Jiexin-Zheng/NXP2020/摄像头上位机/摄像头上位机/esmartcar/ReadMe.txt

该软件需要 Microsoft .Framework 2.0支持，注意是2.0版本的。
如果您的电脑还没有安装2.0版本的，请从以下这些地方下载并安装。

http://www.crsky.com/soft/4818.html
http://www.xiazaiba.com/html/517.html
http://www.duote.com/soft/36225.html
http://www.onlinedown.net/soft/38669.htm
