Jiexin-Zheng/NXP2020/第一次买！必看此说明！否则一切白忙！.txt

1、本资料中电机驱动需要用四路PWM进行控制，但是在主板上只留了两路PWM，因为只需要两路就够了，电机驱动中对角的两个mos管是同时导通的，如果可以，请自己将电机驱动中对角的两个mos控制端短接，实在不会的就自己换个电机驱动吧。
2、摄像头安装时一定要安装正了，摄像头安装角度很有讲究，当液晶屏幕中的图像看到很清楚时候，直接将车放到直道正中间，调节摄像头左右偏向角度，式图像完全摆正。再调节摄像头俯仰角，使摄像头视野最下方距离车头最前端，中间有10厘米距离就可以了，也就是说摄像头是看不到车头前方10厘米以内的区域的。只要做到这点，我保证程序里所有的图像处理算法就会显现出效果，你的程序质量才能发挥出真正的力量。否则一切都是白忙！
3、焦距的调节：焦距就是转动摄像头镜头，在车前方60cm处贴横着贴一到黑胶带，当摄像头完全看起这道胶带就可以了。

以上必须做到！！！！否则一切白忙！
