Jiexin-Zheng/NXP2020/主板器件清单.xls

器件名称 | 描述 | 在原理图中的标号 | 封装 | LibRef | Quantity
电源端子（5mm间距的） |  | *H1 | 端子 | 端子5MM | 1
电机端子 |  | *H2 | 端子 | 端子5MM | 1
1.44LCD（山外小液晶） |  | 1.44LCD | 1.44LCD | 1.44LCD | 1
47uF钽电容 |  | C1, C5, C8 | 3216 | CAP-TAN-47uF | 3
0.1uF |  | C2, C3, C6, C7, C9, C10 | 0805 | CAP-0805_1 | 6
Cap Pol1电解电容 | Polarized Capacitor (Radial) | C4 | 470UF | Cap Pol1 | 1
10uF钽电容 |  | C11 | 3216封装 | CAP-TAN-10uF | 1
FFC_0.5_24 | FFC | FFC1 | 摄像头软排接口（和鹰眼对接） | FFC_0.5_24 | 1
钮子开关 | 钮子开关102 | K1, K2 | 钮子开关 | 钮子开关 | 2
LQ_KXXP144-SYSVG |  | LQ_KXXP144-SYSVG | LQ_KXXP144-SYSVG | LQ_KXXP144-SYSVG | 1
0905小型蜂鸣器 | 0905小蜂鸣器 | LS1 | 0905小型蜂鸣器 | 0905小型蜂鸣器 | 1
Header 4 | Header, 4-Pin | P1 | HDR1X4 | Header 4 | 1
Header 3 | Header, 3-Pin | P2 | HDR1X3 | Header 3 | 1
MOTO | Header, 3-Pin | P3 | HDR1X3 | Header 3 | 1
编码器 | Header, 4-Pin | P4 | HDR1X4 | Header 4 | 1
npn（三极管） |  | Q1 | npn（sot23封装） | npn | 1
R-0603 |  | R1 | R-0603 - duplicate1 | R-0603 | 1
3.3k |  | R2 | 0805 | RES-0805 | 1
1k |  | R3, R4 | 0805 | RES-0805 | 2
10k |  | R5, R6 | 0805 | RES-0805 | 2
LM2940S-3.3V(IMP2940) |  | U1, U2 | LM2940S-5.0（IMP2940） | LM2940S-5.0 | 2
LM2940S-5.0V(IMP2940) |  | U3 | LM2940S-5.0 | LM2940S-5.0 | 1
TL1963() |  | U4 | SOT223-5 | TL1963 | 1
摄像头采用的是山外鹰眼
单片机是龙邱K60
