Jiexin-Zheng/NXP2020/电机驱动器件清单.xls

器件名称 | 描述 | 原理图中的标号 | 封装 | LibRef | Quantity
MC33883(栅压驱动芯片) |  |  | 20-TERMINAL SOICW（sop封装） | MC33883 | 1
Cap Semi | Capacitor (Semiconductor SIM Model) | C1, C2, C3, C4, C5 | C1206 | Cap Semi | 5
LED3 | Typical BLUE SiC LED | D4 | 3.5X2.8X1.9 | LED3 | 1
MOTOR |  | M1 | 两口插座（绿5,mm） | MOTOR | 1
74ls244 |  | N1 | DIP20 | 74ls244 | 1
Header 8 | Header, 8-Pin | P1 | HDR1X8 | Header 8 | 1
IRF3205（mos管） | N-Channel MOSFET | Q1, Q2, Q3, Q4 | IRF3205(TO252封装) | MOSFET-N | 4
50 |  | R1, R2, R5, R6 | 0805 | RES | 4
10 |  | R3, R4 | 0805 | RES | 2
RES |  | R8 | 0805 | RES | 1
单刀开关 |  | S1 | DG1282-5.0 | 单刀开关 | 1
LM2940 | 3-Terminal Positive Voltage Regulator | U1 | 78XX（直插封装） | 78L05 | 1
