Jiexin-Zheng/NXP2020/(list of files, drawings)

Other design files:
B车模摄像头组主板/1.44LCD.PcbLib
B车模摄像头组主板/1.44LCD.SchLib
B车模摄像头组主板/B车模摄像头.PcbDoc
B车模摄像头组主板/B车模摄像头.PrjPcb
B车模摄像头组主板/B车模摄像头.SchDoc
B车模摄像头组主板/LQ_KXXP144-SYSVGPCB.PCBLIB
B车模摄像头组主板/LQ_KXXP144-SYSVGSCH.SCHLIB
电机驱动/飞思卡尔MOS管驱动电路/电机驱动电路.PrjPcb
电机驱动/飞思卡尔MOS管驱动电路/电机驱动电路.SchDoc
