Jiexin-Zheng/NXP2020/B车摄像头程序/program of  C_CAR/App/OLED.c

#include "common.h"
#include "include.h"



#define XLevelL		0x00
#define XLevelH		0x10
#define XLevel		((XLevelH&0x0F)*16+XLevelL)
#define Max_Column	128
#define Max_Row		  64
#define	Brightness	0xCF

/*
4线SPI使用说明：
VBT 供内部DC-DC电压，3.3~4.3V，如果使用5V电压，为保险起见串一个100~500欧的电阻
VCC 供内部逻辑电压 1.8~6V
GND 地

BS0 低电平
BS1 低电平
BS2 低电平

CS  片选管脚
DC  命令数据选择管脚
RES 模块复位管脚
D0（SCLK） ，时钟脚，由MCU控制
D1（MOSI） ，主输出从输入数据脚，由MCU控制

D2 悬空
D3-D7 ， 低电平 ， 也可悬空，但最好设为低电平
RD  低电平 ，也可悬空，但最好设为低电平
RW  低电平 ，也可悬空，但最好设为低电平
RD  低电平 ，也可悬空，但最好设为低电平
C7---D0（SCLK）时钟脚，由MCU控制
C6---D1（MOSI）主输出从输入数据脚，由MCU控制
C0---RST 模块复位管脚
C4---DC  命令数据选择管脚*/

/**************************** 引脚定义 ***********************************
														PE2    RST
														PE2    DC
														PE3    D1
														PE4    D0
*************************************************************************/
#define X_WIDTH 128
#define Y_WIDTH 64
//unsigned char OLED_buffer[1024];





//======================================
const byte F6x8[][6] =
{
    { 0x00, 0x00, 0x00, 0x00, 0x00, 0x00 },   // sp
    { 0x00, 0x00, 0x00, 0x2f, 0x00, 0x00 },   // !
    { 0x00, 0x00, 0x07, 0x00, 0x07, 0x00 },   // "
    { 0x00, 0x14, 0x7f, 0x14, 0x7f, 0x14 },   // #
    { 0x00, 0x24, 0x2a, 0x7f, 0x2a, 0x12 },   // $
    { 0x00, 0x62, 0x64, 0x08, 0x13, 0x23 },   // %
    { 0x00, 0x36, 0x49, 0x55, 0x22, 0x50 },   // &
    { 0x00, 0x00, 0x05, 0x03, 0x00, 0x00 },   // '
    { 0x00, 0x00, 0x1c, 0x22, 0x41, 0x00 },   // (
    { 0x00, 0x00, 0x41, 0x22, 0x1c, 0x00 },   // )
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
0x03,0x07,0x0F,0x1F,0x3F,0x7F,0xFF,0xFF,0xFE,0xFC,0xF1,0xE7,0x8F,0x3F,0x7F,0xFF,
0xFF,0xFF,0xFF,0xFF,0xFF,0xFF,0x7F,0x3F,0x8F,0xE7,0xF1,0xFC,0xFE,0xFF,0xFF,0x7F,
0x3F,0x1F,0x0F,0x07,0x03,0x00,0x00,0x00,0x00,0x00,0x00,0x00,0x00,0x00,0x00,0x00,
0x00,0x00,0x00,0x00,0x00,0x00,0x00,0x00,0x00,0x00,0x00,0x00,0x00,0x00,0x00,0x00,
0x00,0x01,0x01,0x03,0x07,0x07,0x0F,0x1C,0x39,0x07,0x0F,0x3F,0x0F,0x07,0x39,0x1C,
0x0F,0x07,0x07,0x03,0x01,0x01,0x00,0x00,0x00,0x00,0x00,0x00,0x00,0x00,0x00,0x00,
0x00,0x00,0x00,0x00,0x00,0x00,0x00,0x00,
};
*/

/*显示电量数组*/
/*byte dianchi[64] = {
0x00,0x00,0x00,0xF0,0xF0,0x00,0xFC,0x04,0x04,0x04,0x04,0x04,0x04,0x04,0x04,0x04,
0x04,0x04,0x04,0x04,0x04,0x04,0x04,0x04,0x04,0x04,0x04,0x04,0x04,0x04,0xFC,0x00,
0x00,0x00,0x00,0x0F,0x0F,0x00,0x3F,0x20,0x20,0x20,0x20,0x20,0x20,0x20,0x20,0x20,
0x20,0x20,0x20,0x20,0x20,0x20,0x20,0x20,0x20,0x20,0x20,0x20,0x20,0x20,0x3F,0x00
};*/

/*显示蓝牙信号数组*/
/*byte xinghao[64] = {
0x08,0x10,0x20,0x40,0xFF,0x82,0x44,0x28,0x10,0x00,0x00,0x00,0x00,0x00,0x00,0x00,
0x00,0x00,0x00,0x00,0x00,0x00,0x00,0x80,0x00,0xC0,0x00,0xE0,0x00,0xF0,0x00,0x00,
0x08,0x04,0x02,0x01,0x7F,0x20,0x11,0x0A,0x04,0x00,0x00,0x20,0x00,0x30,0x00,0x38,
0x00,0x3C,0x00,0x3E,0x00,0x3F,0x00,0x3F,0x00,0x3F,0x00,0x3F,0x00,0x3F,0x00,0x00
};*/

/*void LCD_WrDat(byte data)
{
	byte i=8;
	//LCD_CS=0;;
	DCHIGH();;;;//DC=1
   //NOP();
	asm("nop");
     CLKLOW();;;;//D0=0
   //NOP();
	 asm("nop");
  while(i--)
  {
    if(data&0x80)
		{MISOHIGH();;;;}//D1=1
    else
		{MISOLOW();;;;}//D1==0
   CLKHIGH();//D0=1
     //NOP();;;;;
		asm("nop");
   CLKLOW();;;;;//D0==0
    data<<=1;
  }
	//LCD_CS=1;
}*/

void LCD_WrDat(byte dat) 
{
byte  i;
DCHIGH(); 
for(i=0;i<8;i++) //发送一个八位数据 
{
if((dat << i) & 0x80)
{MISOHIGH();}
else  MISOLOW();
CLKLOW();
CLKHIGH();
}
}



void LCD_WrCmd(byte cmd)
{
	byte i=8;

	//LCD_CS=0;;
DCLOW();;;;;
 CLKLOW();;;;;
  //asm("nop");

  while(i--)
  {
    if(cmd&0x80)
		{MISOHIGH();;;;;}
    else
		{MISOLOW();;;;;;}
    CLKHIGH();;;;;
     //NOP();;;;;
	asm("nop");
   CLKLOW();;;;;
    cmd<<=1;;;;;
  }
	//LCD_CS=1;
}

void LCD_Set_Pos(byte x, byte y)
{
  LCD_WrCmd(0xb0+y);
  LCD_WrCmd(((x&0xf0)>>4)|0x10);
  LCD_WrCmd(x&0x0f);//|0x01);原来的版本图像整体右移一列，导致低128列移到第一列显示，不知道这么做是为什么，暂时先改回来
}

/*
A13---D0（SCLK）时钟脚，由MCU控制    13
A12---D1（MOSI）主输出从输入数据脚，由MCU控制   12
A15---RST 模块复位管脚  15
A14---DC  命令数据选择管脚     14*/
void OLED_Init(void)
{
//GPIO_Init(OLED_GPIO_DC, DC, GPIO_MODE_OUT_PP_HIGH_FAST);
//GPIO_Init(OLED_GPIO_D1, D1, GPIO_MODE_OUT_PP_HIGH_FAST);
//GPIO_Init(OLED_GPIO_D0, D0, GPIO_MODE_OUT_PP_HIGH_FAST);
//GPIO_Init(OLED_GPIO_RST, RSET, GPIO_MODE_OUT_PP_HIGH_FAST);
  
  
gpio_init(PTA5,GPO,1u);
gpio_init(PTA6,GPO,1u);  
gpio_init(PTA7,GPO,1u);
gpio_init(PTA12,GPO,1u);

	DCHIGH();
	CLKHIGH();

	RESLOW();
  	//LCD_DLY_ms(50);
        systick_delay_ms(100);
        RESHIGH();
/*
  LCD_WrCmd(0xae);//--turn off oled panel
  LCD_WrCmd(0x00);//---set low column address
  LCD_WrCmd(0x10);//---set high column address
  LCD_WrCmd(0x40);//--set start line address  Set Mapping RAM Display Start Line (0x00~0x3F)
  LCD_WrCmd(0x81);//--set contrast control register
  LCD_WrCmd(0xcf); // Set SEG Output Current Brightness   //亮度?
  LCD_WrCmd(0xa1);//--Set SEG/Column Mapping     0xa0左右反置 0xa1正常
   LCD_WrCmd(0xc8);//Set COM/Row Scan Direction   0xc0上下反置 0xc8正常
  //  LCD_WrCmd(0xa0);//--Set SEG/Column Mapping     0xa0左右反置 0xa1正常
 //  LCD_WrCmd(0xc0);//Set COM/Row Scan Direction   0xc0上下反置 0xc8正常
  LCD_WrCmd(0xa6);//--set normal display
  LCD_WrCmd(0xa8);//--set multiplex ratio(1 to 64)
  LCD_WrCmd(0x3f);//--1/64 duty
  LCD_WrCmd(0xd3);//-set display offset	Shift Mapping RAM Counter (0x00~0x3F)
  LCD_WrCmd(0x00);//-not offset
  LCD_WrCmd(0xd5);//--set display clock divide ratio/oscillator frequency
  LCD_WrCmd(0x80);//--set divide ratio, Set Clock as 100 Frames/Sec
  LCD_WrCmd(0xd9);//--set pre-charge period
  LCD_WrCmd(0xf1);//Set Pre-Charge as 15 Clocks & Discharge as 1 Clock
  LCD_WrCmd(0xda);//--set com pins hardware configuration
  LCD_WrCmd(0x12);
  LCD_WrCmd(0xdb);//--set vcomh
  LCD_WrCmd(0x40);//Set VCOM Deselect Level
  LCD_WrCmd(0x20);//-Set Page Addressing Mode (0x00/0x01/0x02)
  LCD_WrCmd(0x02);//
  LCD_WrCmd(0x8d);//--set Charge Pump enable/disable
  LCD_WrCmd(0x14);//--set(0x10) disable
  LCD_WrCmd(0xa4);// Disable Entire Display On (0xa4/0xa5)
  LCD_WrCmd(0xa6);// Disable Inverse Display On (0xa6/a7)
  LCD_WrCmd(0xaf);//--turn on oled panel
  LCD_Fill(0);  //初始清屏
  LCD_Set_Pos(0,0);
*/

LCD_WrCmd(0xae);//--turn off oled panel
LCD_WrCmd(0x00);//---set low column address
LCD_WrCmd(0x10);//---set high column address
LCD_WrCmd(0x40);//--set start line address  Set Mapping RAM Display Start Line (0x00~0x3F)
LCD_WrCmd(0x81);//--set contrast control register//设置对比度控制寄存器
LCD_WrCmd(0x11); // Set SEG Output Current Brightness//输出电流设定亮度0xcf
LCD_WrCmd(0xa1);//--Set SEG/Column Mapping     0xa0左右反置 0xa1正常
LCD_WrCmd(0xc8);//Set COM/Row Scan Direction   0xc0上下反置 0xc8正常
LCD_WrCmd(0xa6);//--set normal display
LCD_WrCmd(0xa8);//--set multiplex ratio(1 to 64)
LCD_WrCmd(0x3f);//--1/64 duty
LCD_WrCmd(0xd3);//-set display offset	Shift Mapping RAM Counter (0x00~0x3F)
LCD_WrCmd(0x00);//-not offset
LCD_WrCmd(0xd5);//--set display clock divide ratio/oscillator frequency
LCD_WrCmd(0x80);//--set divide ratio, Set Clock as 100 Frames/Sec
LCD_WrCmd(0xd9);//--set pre-charge period
LCD_WrCmd(0xf1);//Set Pre-Charge as 15 Clocks & Discharge as 1 Clock
LCD_WrCmd(0xda);//--set com pins hardware configuration
LCD_WrCmd(0x12);
LCD_WrCmd(0xdb);//--set vcomh
LCD_WrCmd(0x40);//Set VCOM Deselect Level
LCD_WrCmd(0x20);//-Set Page Addressing Mode (0x00/0x01/0x02)
LCD_WrCmd(0x02);//
LCD_WrCmd(0x8d);//--set Charge Pump enable/disable
LCD_WrCmd(0x14);//--set(0x10) disable
LCD_WrCmd(0xa4);// Disable Entire Display On (0xa4/0xa5)
LCD_WrCmd(0xa6);// Disable Inverse Display On (0xa6/a7) 
LCD_WrCmd(0xaf);//--turn on oled panel        
LCD_Fill(0x00);  //初始清屏
LCD_Set_Pos(0,0);         
	//DZXH_LOGO();
}




/**************************实现函数********************************************
*函数原型:		void LCD_SetXY(unsigned char X,unsigned char Y)
*功　　能:		将OLED的光标设置到 X,Y 坐标。
*******************************************************************************/
void LCD_SetXY(unsigned char X,unsigned char Y)
{
	LCD_WrCmd(0x22);
	LCD_WrCmd(Y);
	LCD_WrCmd(7);
	LCD_WrCmd(0x21);
	LCD_WrCmd(X);
	LCD_WrCmd(127);
}

void LCD_Fill(byte bmp_data)
{
	byte y,x;

	for(y=0;y<8;y++)
	{
		LCD_WrCmd(0xb0+y);
		LCD_WrCmd(0x01);
		LCD_WrCmd(0x10);
		for(x=0;x<X_WIDTH;x++)
			LCD_WrDat(bmp_data);
	}
}

void LCD_CLS(void)
{
	byte y,x;
	for(y=0;y<8;y++)
	{
		LCD_WrCmd(0xb0+y);
		LCD_WrCmd(0x01);
		LCD_WrCmd(0x10);
		for(x=0;x<X_WIDTH;x++)
			LCD_WrDat(0);
	}
}
void LCD_DLY_ms(word ms)
{
  word a;
  while(ms)
  {
    a=2350;
    while(a--);
    ms--;
  }
  return;
}


//==============================================================
//函数名： void LCD_PutPixel(byte x,byte y)
//功能描述：绘制一个点（x,y）
//参数：真实坐标值(x,y),x的范围0～127，y的范围0～64
//返回：无
//==============================================================
void LCD_PutPixel(byte x,byte y)
{
	byte data1;  //data1当前点的数据

        LCD_Set_Pos(x,y);
	data1 = 0x01<<(y%8);
	LCD_WrCmd(0xb0+(y>>3));
	LCD_WrCmd(((x&0xf0)>>4)|0x10);
	LCD_WrCmd((x&0x0f)|0x00);
	LCD_WrDat(data1);
}



/***********功能描述：显示显示BMP图片128×64起始点坐标(x,y),x的范围0～127，y为页的范围0～7*****************/
void Draw_pot(unsigned char x,unsigned char y,unsigned char t)
{ 	
 
 unsigned char  bx, tmp_lcd=0;
if(x>127||y>63)return;

bx=y%8;
tmp_lcd=1<<(bx);
if(t)
 DRAWPOT[128*(y/8)+x]|=tmp_lcd;
else
 DRAWPOT[128*(y/8)+x]&=~tmp_lcd;
}


void LCD_PXXxYYCHtoBMP(unsigned char xx,unsigned char yy,unsigned char FXXxYY[],unsigned char x,unsigned char y,unsigned char N,unsigned char p)//字符大小XX*YY,对应大小的数组， x坐标，y坐标，第几个数或者字符，阴文/阳文
{
unsigned char t,d,wm=0;
unsigned int adder=(xx*yy)/8*N;
if(yy%8!=0)
d=1;
else
d=0;
for(t=0;t<(yy/8+d);t++){
  for(wm=0;wm<xx;wm++) 
{
if(p==0)
DRAWPOTtempm[128*((y/8)+t)+x+wm]=FXXxYY[adder];
else
DRAWPOTtempm[128*((y/8)+t)+x+wm]=~FXXxYY[adder];
adder += 1;
}
}
}


/***********功能描述：显示显示BMP图片128×64起始点坐标(x,y),x的范围0～127，y为页的范围0～7*****************/
void Draw_BMP(unsigned char x0,unsigned char y0,unsigned char x1,unsigned char y1,unsigned char BMP[])
{ 	
 unsigned int j=0;
 unsigned char x,y;
  
  if(y1%8==0) y=y1/8;      
  else y=y1/8+1;
	for(y=y0;y<y1;y++)
	{
		LCD_Set_Pos(x0,y);				
    for(x=x0;x<x1;x++)
	    {      
	    	LCD_WrDat(BMP[j++]);	    	
	    }
	}
}


//滚动效果调试
void gundong(void){
int d,s;
//if(flag) {
  
for(s=0;s<128;s++) 
   {
  for(d=0;d<128;d++) 
    {
DRAWPOTm[d]=DRAWPOTm[d+1];
DRAWPOTm[d+128*1]=DRAWPOTm[(d+1+128*1)];
DRAWPOTm[d+128*2]=DRAWPOTm[(d+1+128*2)];
DRAWPOTm[d+128*3]=DRAWPOTm[(d+1+128*3)];
DRAWPOTm[d+128*4]=DRAWPOTm[(d+1+128*4)];
DRAWPOTm[d+128*5]=DRAWPOTm[(d+1+128*5)];
DRAWPOTm[d+128*6]=DRAWPOTm[(d+1+128*6)];
DRAWPOTm[d+128*7]=DRAWPOTm[(d+1+128*7)];
   }
DRAWPOTm[127]=DRAWPOTtempm[0+s]; 
DRAWPOTm[127+128*1]=DRAWPOTtempm[1*128+s];
DRAWPOTm[127+128*2]=DRAWPOTtempm[2*128+s];
DRAWPOTm[127+128*3]=DRAWPOTtempm[3*128+s];
DRAWPOTm[127+128*4]=DRAWPOTtempm[4*128+s];
DRAWPOTm[127+128*5]=DRAWPOTtempm[5*128+s];
DRAWPOTm[127+128*6]=DRAWPOTtempm[6*128+s];
DRAWPOTm[127+128*7]=DRAWPOTtempm[7*128+s];
 

Draw_BMP(0,0,128,8,DRAWPOTm);
    }
   // flag=0;
}

//    else
//Draw_BMP(0,0,128,8,DRAWPOTm);
    
   // return flag;

uint gundong_128(uint flag){
//int d,s;
#if 0
if(flag) {
  
for(s=0;s<128;s++) 
   {
  for(d=0;d<128;d++) 
    {
DRAWPOTm[d]=DRAWPOTm[d+1];
DRAWPOTm[d+128*1]=DRAWPOTm[(d+1+128*1)];
DRAWPOTm[d+128*2]=DRAWPOTm[(d+1+128*2)];
DRAWPOTm[d+128*3]=DRAWPOTm[(d+1+128*3)];
DRAWPOTm[d+128*4]=DRAWPOTm[(d+1+128*4)];
DRAWPOTm[d+128*5]=DRAWPOTm[(d+1+128*5)];
DRAWPOTm[d+128*6]=DRAWPOTm[(d+1+128*6)];
DRAWPOTm[d+128*7]=DRAWPOTm[(d+1+128*7)];
   }
DRAWPOTm[127]=DRAWPOTtempm[0+s]; 
DRAWPOTm[127+128*1]=DRAWPOTtempm[1*128+s];
DRAWPOTm[127+128*2]=DRAWPOTtempm[2*128+s];
DRAWPOTm[127+128*3]=DRAWPOTtempm[3*128+s];
DRAWPOTm[127+128*4]=DRAWPOTtempm[4*128+s];
DRAWPOTm[127+128*5]=DRAWPOTtempm[5*128+s];
DRAWPOTm[127+128*6]=DRAWPOTtempm[6*128+s];
DRAWPOTm[127+128*7]=DRAWPOTtempm[7*128+s];
 

Draw_BMP(0,0,128,8,DRAWPOTm);
    }
    flag=0;
}
    else
#endif
//Draw_BMP(0,0,128,8,DRAWPOTm);
Draw_BMP(0,0,128,8,DRAWPOTtempm);
//Draw_BMP(0,0,128,8,BMP3);
//LCD_PXXxYYCHtoBMPL(128,64,DRAWPOTm,0,0,0,0,1);//clear

    
    return flag;
}





void clear_drawpottempm(void) 
{int k;
for(k=0;k<128*8;k++)
 DRAWPOTtempm[k]=0x00;
}


void LCD_P8x16StrtoBMPL(unsigned char x,unsigned char y,signed char ch[],unsigned char z)
{
unsigned char c=0,i=0,j=0;
while (ch[j]!='\0')
{    
c =ch[j]-32;
if(x>120){x=0;y++;}
//LCD_Set_Pos(x,y);    
for(i=0;i<8;i++) {
if(z)
DRAWPOTtempm[128*(y/8)+x+i]=F8X16[c*16+i]; 
else  
DRAWPOTm[128*(y/8)+x+i]=F8X16[c*16+i]; 
}
//LCD_Set_Pos(x,y+8);    
for(i=0;i<8;i++) {
if(z)
DRAWPOTtempm[128*((y/8)+1)+x+i]=F8X16[c*16+i+8];
else  
DRAWPOTm[128*((y/8)+1)+x+i]=F8X16[c*16+i+8];
}
x+=8;
j++;
}
}


void LCD_PXXxYYCHtoBMPL(unsigned char xx,unsigned char yy,unsigned char FXXxYY[],unsigned char x,unsigned char y,unsigned char N,unsigned char p,unsigned char c)//字符大小XX*YY,对应大小的数组， x坐标，y坐标，第几个数或者字符，阴文/阳文,写入哪个GRAM
{
unsigned char t,d,wm=0;
unsigned int adder=(xx*yy)/8*N;
if(yy%8!=0)
d=1;
else
d=0;
for(t=0;t<(yy/8+d);t++){
  for(wm=0;wm<xx;wm++) 
{
if(p==0)
 { if(c)
   DRAWPOTtempm[128*((y/8)+t)+x+wm]=FXXxYY[adder];
 else
  DRAWPOTm[128*((y/8)+t)+x+wm]=FXXxYY[adder];
}
else 
{
if(c)
  DRAWPOTtempm[128*((y/8)+t)+x+wm]=~FXXxYY[adder];
 else
  DRAWPOTm[128*((y/8)+t)+x+wm]=~FXXxYY[adder];
}
adder+= 1;
}
}
}



void ceshi_lock(void) 
{

 clear_drawpottempm();
 //LCD_PXXxYYCHtoBMPL(128,64,cs,0,0,0,0,1);
 
 LCD_P8x16StrtoBMPL(1*16,2*8,"Screen lock!",1);     //字符大小XX*YY,对应大小的数组， x坐标，y坐标，第几个数或者字符，阴文/阳文,写入哪个GRAM
 LCD_P8x16StrtoBMPL(1*16,4*8,"The car run!",1);
}



/*void LCD_PXXxYYCHtoBMPL(unsigned char xx,unsigned char yy,unsigned char FXXxYY[],unsigned char x,unsigned char y,unsigned char N,unsigned char p,unsigned char c)//字符大小XX*YY,对应大小的数组， x坐标，y坐标，第几个数或者字符，阴文/阳文,写入哪个GRAM
{
unsigned char t,d,wm=0;
unsigned int adder=(xx*yy)/8*N;
if(yy%8!=0)
d=1;
else
d=0;
for(t=0;t<(yy/8+d);t++){
  for(wm=0;wm<xx;wm++) 
{
if(p==0)
 { if(c)
   DRAWPOTtempm[128*((y/8)+t)+x+wm]=FXXxYY[adder];
 else
  DRAWPOTm[128*((y/8)+t)+x+wm]=FXXxYY[adder];
}
else 
{
if(c)
  DRAWPOTtempm[128*((y/8)+t)+x+wm]=~FXXxYY[adder];
 else
  DRAWPOTm[128*((y/8)+t)+x+wm]=~FXXxYY[adder];
}
adder += 1;
}
}
}*/

void ceshi(void)
{
  
LCD_PXXxYYCHtoBMP(16,16,F16x16tbm,0,0,4,0);  
LCD_PXXxYYCHtoBMP(16,16,F16x16tbm,16*7,0,7,0);

LCD_PXXxYYCHtoBMP(16,16,F16x16tbm,16*2,0,8,0);
LCD_PXXxYYCHtoBMP(16,16,F16x16tbm,16*3,0,9,0);
LCD_PXXxYYCHtoBMP(16,16,F16x16tbm,16*4,0,10,0);
LCD_PXXxYYCHtoBMP(16,16,F16x16tbm,16*5,0,11,0);

LCD_PXXxYYCHtoBMP(16,16,F16x16tbm,16*1,0,12,0);
LCD_PXXxYYCHtoBMP(16,16,F16x16tbm,16*6,0,13,0);
  
LCD_PXXxYYCHtoBMP(24,24,F24x24,2,16,0,1);
LCD_PXXxYYCHtoBMP(24,24,F24x24,27,16,1,0);
LCD_PXXxYYCHtoBMP(24,24,F24x24,52,16,2,0);
LCD_PXXxYYCHtoBMP(24,24,F24x24,77,16,3,0);
LCD_PXXxYYCHtoBMP(24,24,F24x24,102,16,4,0);

LCD_PXXxYYCHtoBMP(24,24,F24x24,2,40,5,0);
LCD_PXXxYYCHtoBMP(24,24,F24x24,27,40,6,0);
LCD_PXXxYYCHtoBMP(24,24,F24x24,52,40,7,0);
LCD_PXXxYYCHtoBMP(24,24,F24x24,77,40,8,0);
LCD_PXXxYYCHtoBMP(24,24,F24x24,102,40,9,0);
     Draw_BMP(0,0,128,8,DRAWPOT);
}

void ceshi2(void)
{
  

     Draw_BMP(0,0,128,8,cs);
}
//==============================================================
//函数名： void LCD_Rectangle(byte x1,byte y1,
//                   byte x2,byte y2,byte color,byte gif)
//功能描述：绘制一个实心矩形
//参数：左上角坐标（x1,y1）,右下角坐标（x2，y2）
//      其中x1、x2的范围0～127，y1，y2的范围0～63，即真实坐标值
//返回：无
//==============================================================
/*void LCD_Rectangle(byte x1,byte y1,byte x2,byte y2,byte gif)
{
	byte n;

	LCD_Set_Pos(x1,y1>>3);
	for(n=x1;n<=x2;n++)
	{
		LCD_WrDat(0x01<<(y1%8));
		if(gif == 1) 	LCD_DLY_ms(50);
	}
	LCD_Set_Pos(x1,y2>>3);
    for(n=x1;n<=x2;n++)
	{
		LCD_WrDat(0x01<<(y2%8));
		if(gif == 1) 	LCD_DLY_ms(5);
	}

}*/
//==============================================================
//函数名：LCD_P6x8Str(byte x,byte y,byte *p)
//功能描述：写入一组标准ASCII字符串
//参数：显示的位置（x,y），y为页范围0～7，要显示的字符串
//返回：无
//==============================================================




void LCD_P6x8Str(byte x,byte y,byte ch[])
{
  byte c=0,i=0,j=0;
  while (ch[j]!='\0')
  {
    c =ch[j]-32;
    if(x>126){x=0;y++;}
    LCD_Set_Pos(x,y);
  	for(i=0;i<6;i++)
  	  LCD_WrDat(F6x8[c][i]);
  	x+=6;
  	j++;
  }
}


//==============================================================
//函数名：LCD_P8x16Str(byte x,byte y,byte *p)
//功能描述：写入一组标准ASCII字符串
//参数：显示的位置（x,y），y为页范围0～7，要显示的字符串
//返回：无
//==============================================================
/*void LCD_P8x16Str(byte x,byte y,byte ch[])
{
  byte c=0,i=0,j=0;

  while (ch[j]!='\0')
  {
    c =ch[j]-32;
    if(x>120){x=0;y++;}
    LCD_Set_Pos(x,y);
  	for(i=0;i<8;i++)
  	  LCD_WrDat(F8X16[c*16+i]);
  	LCD_Set_Pos(x,y+1);
  	for(i=0;i<8;i++)
  	  LCD_WrDat(F8X16[c*16+i+8]);
  	x+=8;
  	j++;
  }
}*/
//输出汉字字符串
/*
void LCD_P14x16Str(byte x,byte y,byte ch[])
{
	byte wm=0,ii = 0;
	word adder=1;

	while(ch[ii] != '\0')
	{
  	wm = 0;
  	adder = 1;
  	while(F14x16_Idx[wm] > 127)
  	{
  		if(F14x16_Idx[wm] == ch[ii])
  		{
  			if(F14x16_Idx[wm + 1] == ch[ii + 1])
  			{
  				adder = wm * 14;
  				break;
  			}
  		}
  		wm += 2;
  	}
  	if(x>118){x=0;y++;}
  	LCD_Set_Pos(x , y);
  	if(adder != 1)// 显示汉字
  	{
  		LCD_Set_Pos(x , y);
  		for(wm = 0;wm < 14;wm++)
  		{
  			LCD_WrDat(F14x16[adder]);
  			adder += 1;
  		}
  		LCD_Set_Pos(x,y + 1);
  		for(wm = 0;wm < 14;wm++)
  		{
  			LCD_WrDat(F14x16[adder]);
  			adder += 1;
  		}
  	}
  	else			  //显示空白字符
  	{
  		ii += 1;
      LCD_Set_Pos(x,y);
  		for(wm = 0;wm < 16;wm++)
  		{
  				LCD_WrDat(0);
  		}
  		LCD_Set_Pos(x,y + 1);
  		for(wm = 0;wm < 16;wm++)
  		{
  				LCD_WrDat(0);
  		}
  	}
  	x += 14;
  	ii += 2;
	}
}
//输出汉字和字符混合字符串
void LCD_Print(byte x, byte y, byte ch[])
{
	byte ch2[3];
	byte ii=0;
	while(ch[ii] != '\0')
	{
		if(ch[ii] > 127)
		{
			ch2[0] = ch[ii];
	 		ch2[1] = ch[ii + 1];
			ch2[2] = '\0';			//汉字为两个字节
			LCD_P14x16Str(x , y, ch2);	//显示汉字
			x += 14;
			ii += 2;
		}
		else
		{
			ch2[0] = ch[ii];
			ch2[1] = '\0';			//字母占一个字节
			LCD_P8x16Str(x , y , ch2);	//显示字母
			x += 8;
			ii+= 1;
		}
	}
}*/

//==============================================================
//函数名： void Draw_BMP(byte x,byte y)
//功能描述：显示BMP图片128×64
//参数：起始点坐标(x,y),x的范围0～127，y为页的范围0～7
//返回：无
//==============================================================
/*void Draw_BMP(byte x0,byte y0,byte x1,byte y1,byte *bmp)
{
//  word ii=0;
  byte x,y;

  if(y1%8==0)
    y=y1/8;
  else
    y=y1/8+1;
  for(y=y0;y<=y1;y++)
  {
    LCD_Set_Pos(x0,y);
    for(x=x0;x<=x1;x++)
    {
      LCD_WrDat(*bmp++);
    }
  }
}*/

void Dis_Num(byte y, byte x, unsigned int num,byte N)
{
//  byte line;
  byte j=0;
  byte n[6]={0};
  x=x*8;
  n[0]=(num/10000)%10;
  n[1]=(num/1000)%10;
  n[2]=(num/100)%10;
  n[3]=(num/10)%10;
  n[4]=num%10;
//  n[6]='\0';
  for(j=0;j<5;j++)
	n[j]=n[j]+16+32;
  LCD_P6x8Str(x,y,&n[5-N]);//从ACSII码表中读取字节，然后写入液晶
}

void Dis_Numbfb(byte y, byte x, u8 num)
{
  byte n[5]={0};
  x=x*8;
  n[0]=((num/100)%10)+16+32;
   if(n[0]==48)
	 n[0]=32;
  n[1]=((num/10)%10)+16+32;
   //if(n[1]==48)
	// n[1]=32;
  n[2]=(num%10)+16+32;
  n[3]=37;
  LCD_P8x16Str(x,y,&n[0]);//从ACSII码表中读取字节，然后写入液晶
}

/*void Dis_LOGO()
{
	Draw_BMP(36,0,92,7,(u8*)logo);
	LCD_DLY_ms(400);            //显示LOGO延时
	LCD_DLY_ms(400);            //显示LOGO延时
	LCD_DLY_ms(400);            //显示LOGO延时
	LCD_Fill(0x00);  //初始清屏
}*/

void Dis_err(byte y, byte x, s16 num)
{
  byte n[6]={0};
  x=x*8;
  if(num<0)
  {
  	n[0]=45;
	num=-num;
  }
  else if(num>=0)
  {
  	n[0]=43;
  }
  n[1]=(num/1000)%10+16+32;
  n[2]=(num/100)%10+16+32;
  n[3]=46;
  n[4]=(num/10)%10+16+32;
  n[5]=num%10+16+32;
  LCD_P6x8Str(x,y,&n[0]);//从ACSII码表中读取字节，然后写入液晶
}
/*
void Draw_Power(u16 TSC,u8 qie)
{
  byte is;
  byte n[5]={0};
  if(qie==0)
  {
	if(TSC<=630)
	  TSC=630;
	TSC=TSC-630;
	TSC=TSC/10;
	if(TSC>21)
	   TSC=21;
    for(is=0;is<21;is++)
	{
		dianchi[8+is]=0x04;
		dianchi[40+is]=0x20;
	}
    for(is=0;is<TSC;is++)
	{
		dianchi[28-is]=0xF4;
		dianchi[60-is]=0x2F;
	}
	Draw_BMP(96,0,127,1,dianchi);
  }
  if(qie==1)
  {
	TSC=TSC;
	n[0]=(TSC/100)%10+16+32;
    n[1]=46;
    n[2]=(TSC/10)%10+16+32;
    n[3]=TSC%10+16+32;
//    n[4]='\n';
    LCD_P8x16Str(96,0,&n[0]);//从ACSII码表中读取字节，然后写入液晶
  	//Dis_Num(0,11,TSC,4) ;//3
  }

}*/
/*
void Draw_XH()
{
	Draw_BMP(0,0,31,1,xinghao);
}
*/

/*
void LCD_Write_Char(unsigned char ASCII)
{
    unsigned char n;

    ASCII -= 32; //ASCII码-32 得到ASCII字符在点阵中的位置

    for (n=0; n<6; n++)
		LCD_WrDat((F6x8[ASCII][n]));
}*/
/*
void Display_Bar(unsigned char x,unsigned char y,unsigned char num)
{
unsigned char i,j;

	if(num>249)num=249;//限制最大输入为250
i=num/10;  //0-25
LCD_SetXY(x,y);
LCD_WrDat(0x7e);
LCD_WrDat(0x81);
for(j=0;j<i;j++) //开始填充有效的条
{
LCD_WrDat(0xbd);
LCD_WrDat(0xbd);
LCD_WrDat(0xbd);
LCD_WrDat(0x81);
}
if(((num%10)==0)||((num%10)<3))
	{
	LCD_WrDat(0x81);
	LCD_WrDat(0x81);
	LCD_WrDat(0x81);
	LCD_WrDat(0x81);
	}
	else if(((num%10)>=3)&&((num%10)<6))
	{
	LCD_WrDat(0xbd);
	LCD_WrDat(0x81);
	LCD_WrDat(0x81);
	LCD_WrDat(0x81);
	}else if(((num%10)>=6)&&((num%10)<9))
	{
	LCD_WrDat(0xbd);
	LCD_WrDat(0xbd);
	LCD_WrDat(0x81);
	LCD_WrDat(0x81);
	}
	else{
	LCD_WrDat(0xbd);
	LCD_WrDat(0xbd);
	LCD_WrDat(0xbd);
	LCD_WrDat(0x81);
	}

for(j=0;j<24-i;j++) //填充空白条
{
LCD_WrDat(0x81);
LCD_WrDat(0x81);
LCD_WrDat(0x81);
LCD_WrDat(0x81);
}
LCD_WrDat(0x7e);
//显示输入的数据十进制值
//LCD_P6x8Str(110,y,100);
//LCD_Write_Char(num/100+0x30);
//LCD_Write_Char(num%100/10+0x30);
//LCD_Write_Char(num%10+0x30);

}*/
/*
void LED_PrintImage(byte *pucTable, word usRowNum, word usColumnNum)
{
    byte ucData;
    word i,j,k,m,n;
    word usRowTmp;

    m = usRowNum >> 3;   //计算图片行数以8位为一组完整的组数
    n = usRowNum % 8;    //计算分完组后剩下的行数

    for(i = 0; i < m; i++) //完整组行扫描
    {
        LCD_Set_Pos(0,i);
        usRowTmp = i << 3;    //计算当前所在行的下标
        for(j = 0; j < usColumnNum; j++) //列扫描
        {
            ucData = 0;
            for(k = 0; k < 8; k++) //在i组中对这8行扫描
            {
                ucData = ucData >> 1;
                if((pucTable + (usRowTmp + k) * usColumnNum)[j] == 0)
                {
                    ucData = ucData | 0x80;
                }

            }
            LCD_WrDat(ucData);
        }
    }

    LCD_Set_Pos(0,(u8)i); //设置剩下的行显示的起始坐标
    usRowTmp = i << 3;       //计算当前所在行的下标
    for(j = 0; j < usColumnNum; j++) //列扫描
    {
        ucData = 0;
        for(k = 0; k < n; k++) //对剩下的行扫描
        {
            ucData = ucData >> 1;
            if((pucTable + (usRowTmp + k) * usColumnNum)[j] == 0)
            {
                ucData = ucData | 0x80;
            }

        }
        ucData = ucData >> (8 - n);
        LCD_WrDat(ucData);
    }

    return;
}*/



//void OLED_clearbuffer(void)
//{
//	unsigned int j;
//	for(j=0;j<1024;j++)
//	  OLED_buffer[j]=0;
//}

/*void OLED_upbuffer(void)
{
    unsigned int j;
	LCD_SetXY(0,0);
	for(j=0;j<1024;j++)
	  LCD_WrDat(OLED_buffer[j]);
}*/

/*
void LCD_Fill2(byte *bmp_data)
{
	byte y,x;

	for(y=0;y<8;y++)
	{
		LCD_WrCmd(0xb0+y);
		LCD_WrCmd(0x01);
		LCD_WrCmd(0x10);
		for(x=0;x<X_WIDTH;x++)
			LCD_WrDat(*bmp_data++);
	}
}*/

//void OLED_upbuffer(void)
//{
//  LCD_Fill2(OLED_buffer);

//}

/*
void SetPixelbuffer(unsigned char x, unsigned char y, unsigned char color)
{
	if ((x >= COLSIZE-1) || (y >= ROWSIZE*8-1))
		return;
		unsigned char temp;
		temp=OLED_buffer[(y/8)*128+x];
		if (color)temp|=(1<<(y%8));
		else temp&=~(1<<(y%8));
		OLED_buffer[(y/8)*128+x]=temp;
}*/

/*
void DrawLine(unsigned char x0, unsigned char y0, unsigned char x1, unsigned char y1, unsigned char color)
{
	int t;
	char steep = DIF(y1 , y0) > DIF(x1 , x0);
	if (steep)
	{
		t = x0;
		x0 = y0;
		y0 = t;
		t = x1;
		x1 = y1;
		y1 = t;
	}

	if (x0 > x1)
	{
		t = x0;
		x0 = x1;
		x1 = t;

		t = y0;
		y0 = y1;
		y1 = t;
	}

	int dx, dy;
	dx = x1 - x0;
	dy = DIF(y1 , y0);

	int err = (dx / 2);
	int ystep;

	if (y0 < y1)
	{
		ystep = 1;
	}
	else
	{
		ystep = -1;
	}

	for (; x0 < x1; x0++)
	{
		if (steep)
		{
			SetPixelbuffer(y0, x0, color);
		}
		else
		{
			SetPixelbuffer(x0, y0, color);
		}
		err -= dy;
		if (err < 0)
		{
			y0 += (unsigned char)ystep;
			err += dx;
		}
	}
}*/


/**************************************************************************************
                                 *
                                * *
                               *   *
                              *     *
                   * * * * * *       * * * * * *
                    *     * *         * *     *
                     *   * *           * *   *
                      * * *             * * *
                       * *               * *
                        * ******   ****** *
                         *               *
                          *             *
                           *           *
                            *         *
                             *       *
                              *     *
                               *   *
                                * *
                                 * 

                            Diamondhero
                              钻石侠

*类名：OLED功能函数类
**************************************************************************************/


/***********************************************************************************
*                           Diamondhero钻石侠电子工作室
*
*  函数名称：OLED_Draw_pot
*  功能说明：描点函数
*  参数说明：X坐标，Y坐标，阳文/阴文，写入GRAM/VIEW
*  函数返回：无
*  修改时间：2014-5-7
*  备    注：
***********************************************************************************/
void OLED_Draw_pot(unsigned char x,unsigned char y,unsigned char t,unsigned char c)
{ 	
 
 unsigned char  bx, tmp_lcd=0;
if(x>127||y>63)return;

bx=y%8;
tmp_lcd=1<<(bx);
if(t) {
 if(c)
 OLED_GRAM[128*(y/8)+x]|=tmp_lcd; 
 else 
 OLED_VIEW[128*(y/8)+x]|=tmp_lcd; 
}
else {
 if(c)
 OLED_GRAM[128*(y/8)+x]&=~tmp_lcd; 
 else 
 OLED_VIEW[128*(y/8)+x]&=~tmp_lcd; 
}
}

/***********************************************************************************
*                           Diamondhero钻石侠电子工作室
*
*  函数名称：OLED_DrawLine_X
*  功能说明：绘制横线函数
*  参数说明：横线左端X0，横线右端X1，横线所在行Y，写入GRAM/VIEW
*  函数返回：无
*  修改时间：2014-5-7
*  备    注：
***********************************************************************************/
void OLED_DrawLine_X(unsigned char x0,unsigned char x1,unsigned char y,unsigned char c) 
 {
 unsigned char linetemp,l;
   if(x0>x1) 
   {
 linetemp=x1;
 x1=x0;
 x0=linetemp;
 }
   for(l=x0;l<=x1;l++)
   OLED_Draw_pot(l,y,1,c); 
 }

/***********************************************************************************
*                           Diamondhero钻石侠电子工作室
*
*  函数名称：OLED_DrawLine_Y
*  功能说明：绘制纵线函数
*  参数说明：纵线上端Y0，纵线下端Y1，纵线所在列X，写入GRAM/VIEW
*  函数返回：无
*  修改时间：2014-5-7
*  备    注：
***********************************************************************************/
 void OLED_DrawLine_Y(unsigned char y0,unsigned char y1,unsigned char x,unsigned char c) 
 {
 unsigned char linetemp,l;
   if(y0>y1) 
   {
 linetemp=y1;
 y1=y0;                 
 y0=linetemp;
 }
   for(l=y0;l<=y1;l++)
     OLED_Draw_pot(x,l,1,c); 
 }

/***********************************************************************************
*                           Diamondhero钻石侠电子工作室
*
*  函数名称：OLED_write_6X8String
*  功能说明：写6X8字符串函数
*  参数说明：显示的坐标x,y），y为页范围0～7，显示的字符串，写入GRAM/VIEW
*  函数返回：无
*  修改时间：2014-5-7
*  备    注：
***********************************************************************************/
void OLED_write_6X8String(signed char x,signed char y,signed char ch[],unsigned char z)
{
signed char c=0,k=0,j=0;      
while (ch[j]!='\0')
{    
c=ch[j]-32;
if(x>126){x=0;y++;}
//LCD_Set_Pos(x,y);    
for(k=0;k<6;k++) {
if(z)
 OLED_GRAM[128*(y/8)+x+k]=F6x8[c][k]; 
else
 OLED_VIEW[128*(y/8)+x+k]=F6x8[c][k]; 
}
x+=6;
j++;
}
}

/***********************************************************************************
*                           Diamondhero钻石侠电子工作室
*
*  函数名称：OLED_write_8X16String
*  功能说明：写8X16字符串函数
*  参数说明：显示的坐标x,y），x为0*8~16*8，y为页范围0*16~3*16，显示的字符串，写入GRAM/VIEW
*  函数返回：无
*  修改时间：2014-5-7
*  备    注：
***********************************************************************************/
void OLED_write_8X16String(unsigned char x,unsigned char y, char ch[],unsigned char z)
{
unsigned char c=0,i=0,j=0;
while (ch[j]!='\0')
{    
c =ch[j]-32;
if(x>120){x=0;y++;}
//LCD_Set_Pos(x,y);    
for(i=0;i<8;i++) {
if(z)
OLED_GRAM[128*(y/8)+x+i]=F8X16[c*16+i]; 
else  
OLED_VIEW[128*(y/8)+x+i]=F8X16[c*16+i]; 
}
//LCD_Set_Pos(x,y+8);    
for(i=0;i<8;i++) {
if(z)
OLED_GRAM[128*((y/8)+1)+x+i]=F8X16[c*16+i+8];
else  
OLED_VIEW[128*((y/8)+1)+x+i]=F8X16[c*16+i+8];
}
x+=8;
j++;
}
}

/***********************************************************************************
*                           Diamondhero钻石侠电子工作室
*
*  函数名称：OLED_Diamondhero_Draw_XXYY
*  功能说明：Drawing function at any position of any size
*  参数说明：size(xx,yy),An array of the same size,X coordinates,Y coordinates,The number in the array,characters cut in relief or intaglio,Write in GRAM or VIEW
*  函数返回：无
*  修改时间：2014-5-7
*  备    注：
***********************************************************************************/
void OLED_Diamondhero_Draw_XXYY(unsigned char xx,unsigned char yy,unsigned char FXXxYY[],unsigned char x,unsigned char y,unsigned char N,unsigned char p,unsigned char c)
{
unsigned char t,d,wm=0;
unsigned int adder=(xx*yy)/8*N;
if(yy%8!=0)
d=1;
else
d=0;
for(t=0;t<(yy/8+d);t++){
  for(wm=0;wm<xx;wm++) 
{
if(p==0)
 { if(c)
  OLED_GRAM[128*((y/8)+t)+x+wm]=FXXxYY[adder];
 else
  OLED_VIEW[128*((y/8)+t)+x+wm]=FXXxYY[adder];
}
else 
{
if(c)
  OLED_GRAM[128*((y/8)+t)+x+wm]=~FXXxYY[adder];
 else
  OLED_VIEW[128*((y/8)+t)+x+wm]=~FXXxYY[adder];
}
adder += 1;
}
}
}


/***********************************************************************************
*                           Diamondhero钻石侠电子工作室
*
*  函数名称：OLED_VIEW_OUT
*  功能说明：显示函数
*  参数说明：显示的起始坐标x0,y0），显示的终止坐标x1,y1），一般用OLED_VIEW
*  函数返回：无
*  修改时间：2014-5-7
*  备    注：
***********************************************************************************/
void OLED_VIEW_OUT(unsigned char x0,unsigned char y0,unsigned char x1,unsigned char y1,unsigned char BMP[])
{ 	
 unsigned int j=0;
 unsigned char x,y;
  
  if(y1%8==0) y=y1/8;      
  else y=y1/8+1;
	for(y=y0;y<y1;y++)
	{
		LCD_Set_Pos(x0,y);				
        for(x=x0;x<x1;x++)
	    {      
	    	LCD_WrDat(BMP[j++]);	    	
	    }
	}
}


/***********************************************************************************
*                           Diamondhero钻石侠电子工作室
*
*  函数名称：clear_OLED_GRAM
*  功能说明：清除GRAM缓存
*  参数说明：无
*  函数返回：无
*  修改时间：2014-5-7
*  备    注：
***********************************************************************************/
void clear_OLED_GRAM(void) 
{int k;
for(k=0;k<128*8;k++)
 OLED_GRAM[k]=0x00;
}

/***********************************************************************************
*                           Diamondhero钻石侠电子工作室
*
*  函数名称：VIEW_Rolling_effect
*  功能说明：从VIEW当前滚动出GRAM特效
*  参数说明：无
*  函数返回：无
*  修改时间：2014-5-7
*  备    注：
***********************************************************************************/
void VIEW_Rolling_effect(void)
{
int d,s;
for(s=0;s<128;s++)    //滚动一次要显示128次左移
   {
  for(d=0;d<128;d++)  //每次左移
    {
OLED_VIEW[d]=OLED_VIEW[d+1];
OLED_VIEW[d+128*1]=OLED_VIEW[(d+1+128*1)];
OLED_VIEW[d+128*2]=OLED_VIEW[(d+1+128*2)];
OLED_VIEW[d+128*3]=OLED_VIEW[(d+1+128*3)];
OLED_VIEW[d+128*4]=OLED_VIEW[(d+1+128*4)];
OLED_VIEW[d+128*5]=OLED_VIEW[(d+1+128*5)];
OLED_VIEW[d+128*6]=OLED_VIEW[(d+1+128*6)];
OLED_VIEW[d+128*7]=OLED_VIEW[(d+1+128*7)];
   }
OLED_VIEW[127]=OLED_GRAM[0+s];            //每次移动 补一列
OLED_VIEW[127+128*1]=OLED_GRAM[1*128+s];
OLED_VIEW[127+128*2]=OLED_GRAM[2*128+s];
OLED_VIEW[127+128*3]=OLED_GRAM[3*128+s];
OLED_VIEW[127+128*4]=OLED_GRAM[4*128+s];
OLED_VIEW[127+128*5]=OLED_GRAM[5*128+s];
OLED_VIEW[127+128*6]=OLED_GRAM[6*128+s];
OLED_VIEW[127+128*7]=OLED_GRAM[7*128+s];
 
OLED_VIEW_OUT(0,0,128,8,OLED_VIEW);
    } 
}


void VIEW_Rolling_effect2(void)  //成功 1/2标准速度滚动，向左边移动两格显示一次
{
int d,s;
for(s=0;s<64;s++)    //滚动一次要显示128次左移
   {
  for(d=0;d<128;d++)  //每次左移 每次赋值 移动一格
    {
OLED_VIEW[d]=OLED_VIEW[d+1];                //后一列给前一列 后一列给前一列
OLED_VIEW[d+128*1]=OLED_VIEW[(d+1+128*1)];
OLED_VIEW[d+128*2]=OLED_VIEW[(d+1+128*2)];
OLED_VIEW[d+128*3]=OLED_VIEW[(d+1+128*3)];
OLED_VIEW[d+128*4]=OLED_VIEW[(d+1+128*4)];
OLED_VIEW[d+128*5]=OLED_VIEW[(d+1+128*5)];
OLED_VIEW[d+128*6]=OLED_VIEW[(d+1+128*6)];
OLED_VIEW[d+128*7]=OLED_VIEW[(d+1+128*7)];
   }
OLED_VIEW[127]=OLED_GRAM[0+2*s];            //末尾列 补上 GRAM的初列！！！！
OLED_VIEW[127+128*1]=OLED_GRAM[1*128+2*s];
OLED_VIEW[127+128*2]=OLED_GRAM[2*128+2*s];
OLED_VIEW[127+128*3]=OLED_GRAM[3*128+2*s];
OLED_VIEW[127+128*4]=OLED_GRAM[4*128+2*s];
OLED_VIEW[127+128*5]=OLED_GRAM[5*128+2*s];
OLED_VIEW[127+128*6]=OLED_GRAM[6*128+2*s];
OLED_VIEW[127+128*7]=OLED_GRAM[7*128+2*s];

for(d=0;d<128;d++)  //每次左移 每次赋值 移动一格
    {
OLED_VIEW[d]=OLED_VIEW[d+1];                //后一列给前一列 后一列给前一列
OLED_VIEW[d+128*1]=OLED_VIEW[(d+1+128*1)];
OLED_VIEW[d+128*2]=OLED_VIEW[(d+1+128*2)];
OLED_VIEW[d+128*3]=OLED_VIEW[(d+1+128*3)];
OLED_VIEW[d+128*4]=OLED_VIEW[(d+1+128*4)];
OLED_VIEW[d+128*5]=OLED_VIEW[(d+1+128*5)];
OLED_VIEW[d+128*6]=OLED_VIEW[(d+1+128*6)];
OLED_VIEW[d+128*7]=OLED_VIEW[(d+1+128*7)];
   }
OLED_VIEW[127]=OLED_GRAM[0+2*s+1];            //末尾列 补上 GRAM的其次列！！！！
OLED_VIEW[127+128*1]=OLED_GRAM[1*128+2*s+1];
OLED_VIEW[127+128*2]=OLED_GRAM[2*128+2*s+1];
OLED_VIEW[127+128*3]=OLED_GRAM[3*128+2*s+1];
OLED_VIEW[127+128*4]=OLED_GRAM[4*128+2*s+1];
OLED_VIEW[127+128*5]=OLED_GRAM[5*128+2*s+1];
OLED_VIEW[127+128*6]=OLED_GRAM[6*128+2*s+1];
OLED_VIEW[127+128*7]=OLED_GRAM[7*128+2*s+1];

 
OLED_VIEW_OUT(0,0,128,8,OLED_VIEW);
    } 
}


void VIEW_Rolling_effect_R(void)
{
int d,s;
for(s=127;s>=0;s--)    //滚动一次要显示128次左移
   {
  for(d=127;d>=0;d--)  //每次左移
    {
OLED_VIEW[d]=OLED_VIEW[d-1];
OLED_VIEW[d+128*1]=OLED_VIEW[(d-1+128*1)];
OLED_VIEW[d+128*2]=OLED_VIEW[(d-1+128*2)];
OLED_VIEW[d+128*3]=OLED_VIEW[(d-1+128*3)];
OLED_VIEW[d+128*4]=OLED_VIEW[(d-1+128*4)];
OLED_VIEW[d+128*5]=OLED_VIEW[(d-1+128*5)];
OLED_VIEW[d+128*6]=OLED_VIEW[(d-1+128*6)];
OLED_VIEW[d+128*7]=OLED_VIEW[(d-1+128*7)];
   }
OLED_VIEW[0]=OLED_GRAM[0+s];            //每次移动 补一列
OLED_VIEW[0+128*1]=OLED_GRAM[1*128+s];
OLED_VIEW[0+128*2]=OLED_GRAM[2*128+s];
OLED_VIEW[0+128*3]=OLED_GRAM[3*128+s];
OLED_VIEW[0+128*4]=OLED_GRAM[4*128+s];
OLED_VIEW[0+128*5]=OLED_GRAM[5*128+s];
OLED_VIEW[0+128*6]=OLED_GRAM[6*128+s];
OLED_VIEW[0+128*7]=OLED_GRAM[7*128+s];
 
OLED_VIEW_OUT(0,0,128,8,OLED_VIEW);
    } 
}

void VIEW_Rolling_effect_R2(void)  //快速右移
{
int d,s;
for(s=63;s>=0;s--)    //滚动一次要显示128次左移
   {
  for(d=127;d>=0;d--)  //每次左移
    {
OLED_VIEW[d]=OLED_VIEW[d-1];
OLED_VIEW[d+128*1]=OLED_VIEW[(d-1+128*1)];
OLED_VIEW[d+128*2]=OLED_VIEW[(d-1+128*2)];
OLED_VIEW[d+128*3]=OLED_VIEW[(d-1+128*3)];
OLED_VIEW[d+128*4]=OLED_VIEW[(d-1+128*4)];
OLED_VIEW[d+128*5]=OLED_VIEW[(d-1+128*5)];
OLED_VIEW[d+128*6]=OLED_VIEW[(d-1+128*6)];
OLED_VIEW[d+128*7]=OLED_VIEW[(d-1+128*7)];
   }
OLED_VIEW[0]=OLED_GRAM[0+2*s];            //每次移动 补一列
OLED_VIEW[0+128*1]=OLED_GRAM[1*128+2*s];
OLED_VIEW[0+128*2]=OLED_GRAM[2*128+2*s];
OLED_VIEW[0+128*3]=OLED_GRAM[3*128+2*s];
OLED_VIEW[0+128*4]=OLED_GRAM[4*128+2*s];
OLED_VIEW[0+128*5]=OLED_GRAM[5*128+2*s];
OLED_VIEW[0+128*6]=OLED_GRAM[6*128+2*s];
OLED_VIEW[0+128*7]=OLED_GRAM[7*128+2*s];

 for(d=127;d>=0;d--)  //每次左移
    {
OLED_VIEW[d]=OLED_VIEW[d-1];
OLED_VIEW[d+128*1]=OLED_VIEW[(d-1+128*1)];
OLED_VIEW[d+128*2]=OLED_VIEW[(d-1+128*2)];
OLED_VIEW[d+128*3]=OLED_VIEW[(d-1+128*3)];
OLED_VIEW[d+128*4]=OLED_VIEW[(d-1+128*4)];
OLED_VIEW[d+128*5]=OLED_VIEW[(d-1+128*5)];
OLED_VIEW[d+128*6]=OLED_VIEW[(d-1+128*6)];
OLED_VIEW[d+128*7]=OLED_VIEW[(d-1+128*7)];
   }
OLED_VIEW[0]=OLED_GRAM[0+2*s-1];            //每次移动 补一列
OLED_VIEW[0+128*1]=OLED_GRAM[1*128+2*s-1];
OLED_VIEW[0+128*2]=OLED_GRAM[2*128+2*s-1];
OLED_VIEW[0+128*3]=OLED_GRAM[3*128+2*s-1];
OLED_VIEW[0+128*4]=OLED_GRAM[4*128+2*s-1];
OLED_VIEW[0+128*5]=OLED_GRAM[5*128+2*s-1];
OLED_VIEW[0+128*6]=OLED_GRAM[6*128+2*s-1];
OLED_VIEW[0+128*7]=OLED_GRAM[7*128+2*s-1];


 
OLED_VIEW_OUT(0,0,128,8,OLED_VIEW);
    } 
}




void countprint(int x,char y[]) 
{
 int a,b,c,d,e;
 for(e=0;e<4;e++)
 y[e]=0;
 if(x>=0)
      {
      a=x/1000;
      b=x%1000/100;
      c=x%100/10;
      d=x%10;
 
          if(c==0&&b==0&&a==0) 
              {
                y[0]=' ';
                y[1]=' ';
                y[2]=' ';
                sprintf(y+3,"%d",d);
               }
          else if(a==0&&b==0) 
              {
                y[0]=' ';
                y[1]=' ';
                sprintf(y+2,"%d",c);
                sprintf(y+3,"%d",d);
              }
         else if(a==0) 
              {
                y[0]=' ';
                sprintf(y+1,"%d",b);
                sprintf(y+2,"%d",c);
                sprintf(y+3,"%d",d);
              } 
          else 
              {
                sprintf(y,"%d",a);
                sprintf(y+1,"%d",b);
                sprintf(y+2,"%d",c);
                sprintf(y+3,"%d",d);
              }
      } 
 
else
     {
        x=abs(x);
        b=x%1000/100;
        c=x%100/10;
        d=x%10;
        if(c==0&&b==0) 
             {
              y[0]=' ';
              y[1]=' ';
              y[2]='-';
              sprintf(y+3,"%d",d);
             }
        else if(b==0) 
            {
              y[0]=' ';
              y[1]='-'; 
              sprintf(y+2,"%d",c);
              sprintf(y+3,"%d",d);
             }
        else
             {
  //y[0]='-';
              y[0]='-';
 //sprintf(y,"%d",a);
              sprintf(y+1,"%d",b);
              sprintf(y+2,"%d",c);
              sprintf(y+3,"%d",d); 
              }
       }
 }
/*************************************************************************************


*类名：OLED用户DIY函数类
**************************************************************************************/

void OLED_ceshi(void)
{
  clear_OLED_GRAM(); 
  OLED_Diamondhero_Draw_XXYY(128,64,cs,0,0,0,0,1);
  VIEW_Rolling_effect2();
}
void OLED_ceshi2(void)
{
  clear_OLED_GRAM(); 
  OLED_Diamondhero_Draw_XXYY(128,64,DRAWPOTtemp,0,0,0,0,1);
  VIEW_Rolling_effect_R2();
}

void OLED_ceshi3(void)
{

clear_OLED_GRAM(); 

  
OLED_Diamondhero_Draw_XXYY(16,16,F16x16tbm,0,0,4,0,1);  
OLED_Diamondhero_Draw_XXYY(16,16,F16x16tbm,16*7,0,7,0,1);

OLED_Diamondhero_Draw_XXYY(16,16,F16x16tbm,16*2,0,8,0,1);
OLED_Diamondhero_Draw_XXYY(16,16,F16x16tbm,16*3,0,9,0,1);
OLED_Diamondhero_Draw_XXYY(16,16,F16x16tbm,16*4,0,10,0,1);
OLED_Diamondhero_Draw_XXYY(16,16,F16x16tbm,16*5,0,11,0,1);

OLED_Diamondhero_Draw_XXYY(16,16,F16x16tbm,16*1,0,12,0,1);
OLED_Diamondhero_Draw_XXYY(16,16,F16x16tbm,16*6,0,13,0,1);
  
OLED_Diamondhero_Draw_XXYY(24,24,F24x24,2,16,0,1,1);
OLED_Diamondhero_Draw_XXYY(24,24,F24x24,27,16,1,0,1);
OLED_Diamondhero_Draw_XXYY(24,24,F24x24,52,16,2,0,1);
OLED_Diamondhero_Draw_XXYY(24,24,F24x24,77,16,3,0,1);
OLED_Diamondhero_Draw_XXYY(24,24,F24x24,102,16,4,0,1);

OLED_Diamondhero_Draw_XXYY(24,24,F24x24,2,40,5,0,1);
OLED_Diamondhero_Draw_XXYY(24,24,F24x24,27,40,6,0,1);
OLED_Diamondhero_Draw_XXYY(24,24,F24x24,52,40,7,0,1);
OLED_Diamondhero_Draw_XXYY(24,24,F24x24,77,40,8,0,1);
OLED_Diamondhero_Draw_XXYY(24,24,F24x24,102,40,9,0,1);
     VIEW_Rolling_effect();
}


void OLED_ceshi4(void)
{

clear_OLED_GRAM(); 

  
OLED_Diamondhero_Draw_XXYY(16,16,F16x16tbm,0,0,4,0,1);  
OLED_Diamondhero_Draw_XXYY(16,16,F16x16tbm,16*7,0,7,0,1);

OLED_Diamondhero_Draw_XXYY(16,16,F16x16tbm,16*2,0,8,0,1);
OLED_Diamondhero_Draw_XXYY(16,16,F16x16tbm,16*3,0,9,0,1);
OLED_Diamondhero_Draw_XXYY(16,16,F16x16tbm,16*4,0,10,0,1);
OLED_Diamondhero_Draw_XXYY(16,16,F16x16tbm,16*5,0,11,0,1);

OLED_Diamondhero_Draw_XXYY(16,16,F16x16tbm,16*1,0,12,0,1);
OLED_Diamondhero_Draw_XXYY(16,16,F16x16tbm,16*6,0,13,0,1);
  
OLED_Diamondhero_Draw_XXYY(128,48,F128X48,0,16,0,0,1);

     VIEW_Rolling_effect();
}



void OLED_ceshi5(void)
{

//clear_OLED_GRAM(); 


  
OLED_Diamondhero_Draw_XXYY(64,32,F64X32,16*2,16,0,0,0);
OLED_Diamondhero_Draw_XXYY(64,32,F64X32,16*2,16,1,0,0);
OLED_VIEW_OUT(0,0,128,8,OLED_VIEW);
     //VIEW_Rolling_effect();
}


/*int Backtom(int flag,int k) 
{
    keyright_=keyRight;
      if(!keyright_) 
            {
                systick_delay_ms(20);
                keyright_=keyRight;
                if(!keyright_)
                {   keyright_=keyRight; 
                    while(!keyright_)
                    {keyright_=keyRight;};
                    flag_LCD_first=1;
                    flag=0;
                    flag_gundongs[k]=1;
                    flag_gundongm=1;
                    //LCD_CLS();
                    
                }
            }
            return flag;  
}*/

/***********功能描述：显示显示BMP图片128×64起始点坐标(x,y),x的范围0～127，y为页的范围0～7*****************/
void Draw_potL(unsigned char x,unsigned char y,unsigned char t,unsigned char c)
{ 	
 
unsigned char  bx, tmp_lcd=0;
if(x>127||y>63)return;

bx=y%8;
tmp_lcd=1<<(bx);
if(t) {
 if(c)
 DRAWPOTtempm[128*(y/8)+x]|=tmp_lcd; 
 else 
 DRAWPOTm[128*(y/8)+x]|=tmp_lcd; 
}
else {
 if(c)
 DRAWPOTtempm[128*(y/8)+x]&=~tmp_lcd; 
 else 
 DRAWPOTm[128*(y/8)+x]&=~tmp_lcd; 
}
}

void DrawLineX_fL(unsigned char x0,unsigned char x1,unsigned char y,unsigned char c) 
 {
 unsigned char linetemp,l;
   if(x0>x1) 
   {
 linetemp=x1;
 x1=x0;
 x0=linetemp;
 }
   for(l=x0;l<=x1;l++)
   Draw_potL(l,y,1,c); 
 }
 
 void DrawLineY_fL(unsigned char y0,unsigned char y1,unsigned char x,unsigned char c) 
 {
 unsigned char linetemp,l;
   if(y0>y1) 
   {
 linetemp=y1;
 y1=y0;                 
 y0=linetemp;
 }
   for(l=y0;l<=y1;l++)
     Draw_potL(x,l,1,c); 
 }

/***************功能描述：显示6*8一组标准ASCII字符串	显示的坐标（x,y），y为页范围0～7****************/
void LCD_6x8StrtoBMPL(uchar x,uchar y,signed char ch[],unsigned char z)
{
uchar c=0,k=0,j=0;      
while (ch[j]!='\0')
{    
c=ch[j]-32;
if(x>126){x=0;y++;}
//LCD_Set_Pos(x,y);    
for(k=0;k<6;k++) {
if(z)
  DRAWPOTtempm[128*(y/8)+x+k]=F6x8[c][k]; 
else
  DRAWPOTm[128*(y/8)+x+k]=F6x8[c][k]; 
}
x+=6;
j++;
}
}
