Jiexin-Zheng/NXP2020/B车摄像头程序/program of  C_CAR/App/duoji_dianji.h

#include "include.h"
#define steer_mid 770//8025
#define steer_max 8750//9000
#define steer_min 6750  //7050

extern s16 speed_a,speed_b;

void duoji_dianji_Init(void);
void get_pulse(void);
void FTM_QUAD_init();
void dianji_zhengzhuan_zuo(int zhankongbi);
void dianji_zhengzhuan_you(int zhankongbi);
void dianji_fanzhuan_zuo(int zhankongbi);
void dianji_fanzhuan_you(int zhankongbi);
void dianji_PID_zuo(int QWMC_zuo);
void dianji_PID_you(int QWMC_you);
void motor_parameters_init(void);
void motor_pid(int pulse_to_set);
