Jiexin-Zheng/NXP2020/B车摄像头程序/program of  C_CAR/App/saomiao.h

#ifndef saomiao_h
#define saomiao_h
void congzhongjianwangliangbian();
void scan_from_middle();
void error_handle();
void lkshaomiao();
//void straight_line_extension(int x1,int y1,int x2,int y2)
extern int rushiziy,rushizix,rushiziy2,rushizix2;
#endif
