Jiexin-Zheng/NXP2020/B车摄像头程序/program of  C_CAR/Board/inc/VCAN_LCD_ILI9341.h

/*!
 *     COPYRIGHT NOTICE
 *     Copyright (c) 2013,山外科技
 *     All rights reserved.
 *     技术讨论：山外论坛 http://www.vcan123.com
 *
 *     除注明出处外，以下所有内容版权均属山外科技所有，未经允许，不得用于商业用途，
 *     修改内容时必须保留山外科技的版权声明。
 *
 * @file       VCAN_LCD_ILI9341.h
 * @brief      LCD ILI9341函数库
 * @author     山外科技
 * @version    v5.0
 * @date       2013-09-03
 */
#ifndef _VCAN_LCD_ILI9341_H_
#define _VCAN_LCD_ILI9341_H_


#include "MK60_flexbus.h"


//用户配置
#define ILI9341_DIR_DEFAULT     1       //定义默认方向 (0~3)


#if (USE_LCD == LCD_ILI9341)

/*********************** API接口 ******************************/
//提供API接口给LCD调用

#define LCD_H                   ILI9341_get_h()                 //高
#define LCD_W                   ILI9341_get_w()                 //宽

#define LCD_INIT()              LCD_ILI9341_init()              //初始化
#define LCD_PTLON(site,size)    LCD_ILI9341_ptlon(site,size)    //开窗
#define LCD_RAMWR()             LCD_ILI9341_WR_CMD(0x2C)        //写模式
#define LCD_WR_DATA(data)       LCD_ILI9341_WR_DATA(data)       //写数据
#define LCD_WR_CMD(cmd)         LCD_ILI9341_WR_CMD(cmd)         //命令
#define LCD_SET_DIR(opt)        LCD_ILI9341_dir(opt)            //方向

#define LCD_DIR                 ILI9341_get_dir()               //获取方向

#endif //(USE_LCD == LCD_ILI9341)

/********************* ILI9341内部实现 ***********************/

#define LCD_ILI9341_CMD_ADDR                    FB_8080_CMD
#define LCD_ILI9341_DATA_ADDR                   FB_8080_DATA

#define LCD_ILI9341_WR_CMD(cmd)         do{LCD_ILI9341_CMD_ADDR  = cmd ;}while(0)
#define LCD_ILI9341_WR_DATA(data)       do{LCD_ILI9341_DATA_ADDR = data;}while(0)


extern void     LCD_ILI9341_init();
extern void     LCD_ILI9341_dir(uint8 option);
extern void     LCD_ILI9341_ptlon(Site_t site, Size_t size);
extern uint16   ILI9341_get_h();
extern uint16   ILI9341_get_w();
extern uint8    ILI9341_get_dir();




#endif //   _VCAN_LCD_ILI9341_H_
