Jiexin-Zheng/NXP2020/(notices)

Notices in the files:
B车摄像头程序/program of C_CAR/App/flash.h:
(C) COPYRIGHT 2016 Ì©Çìµç×Ó¿Æ¼¼
B车摄像头程序/program of C_CAR/Board/src/VCAN_LED.C:
Copyright (c) 2014,É½Íâ¿Æ¼¼
All rights reserved.
B车摄像头程序/program of C_CAR/Board/inc/VCAN_LCD_ILI9341.h:
Copyright (c) 2013,É½Íâ¿Æ¼¼
